YinniKun/led_flight_info/models/complete_enclosure_assembly_neg10deg.stl

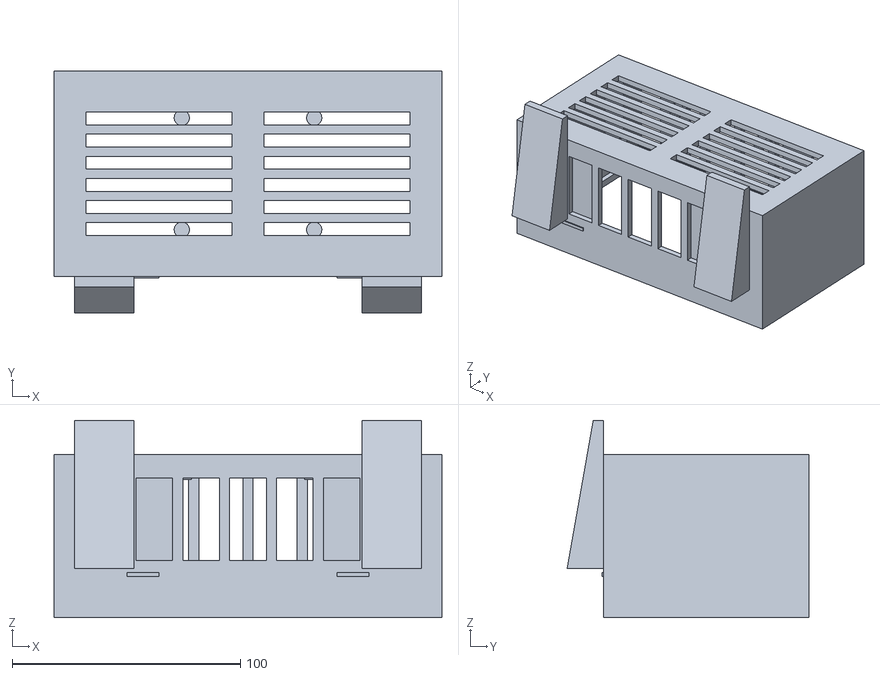
[picture p1: CAD file, 2026-11-08]
models/complete_enclosure_assembly_neg10deg.stl
170.0 x 106.0 x 86.5
