YinniKun/led_flight_info/models/rear_chassis_enclosure.stl

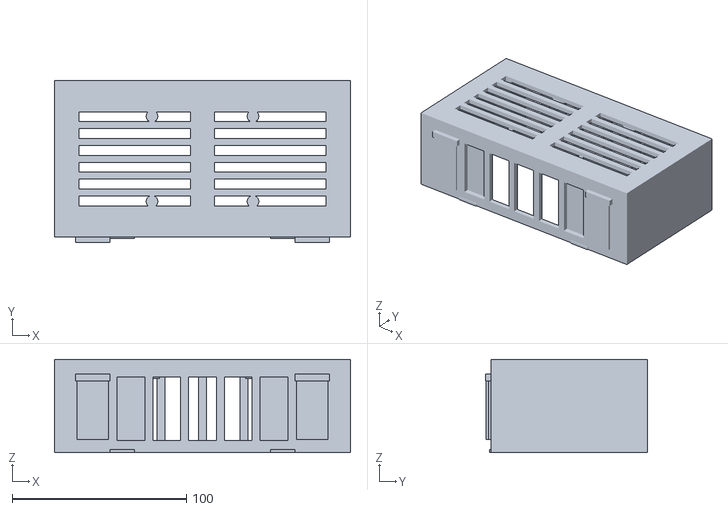
[picture p2: CAD file, 2026-11-08]
models/rear_chassis_enclosure.stl
170.0 x 93.0 x 53.5
