YinniKun/led_flight_info/models/display_front_bezel.stl

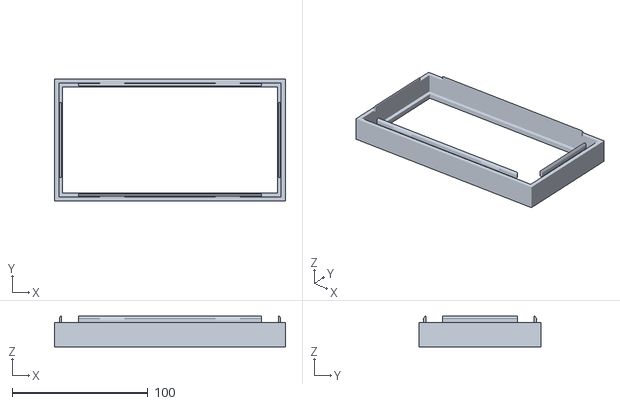
[picture p3: CAD file, 2026-11-08]
models/display_front_bezel.stl
170.0 x 90.0 x 22.5
