YinniKun/led_flight_info/models/modular_foot_-15deg.stl

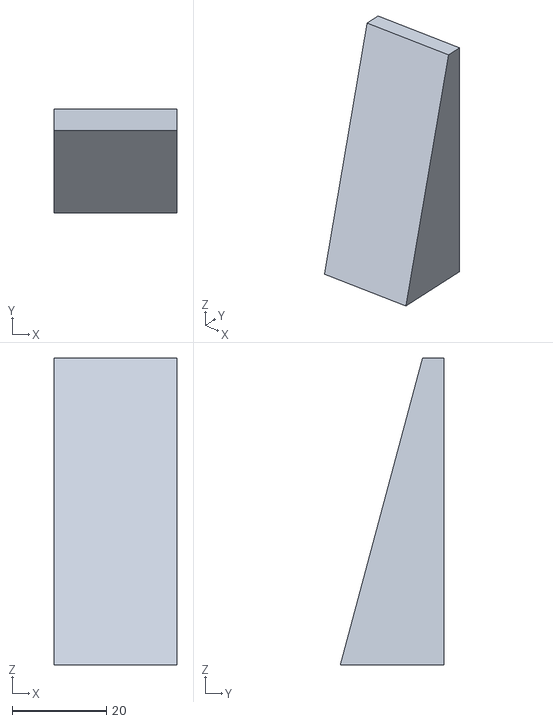
[picture p4: CAD file, 2026-11-08]
models/modular_foot_-15deg.stl
26.0 x 21.9 x 65.0
