YinniKun/led_flight_info/models/modular_foot_-10deg.stl

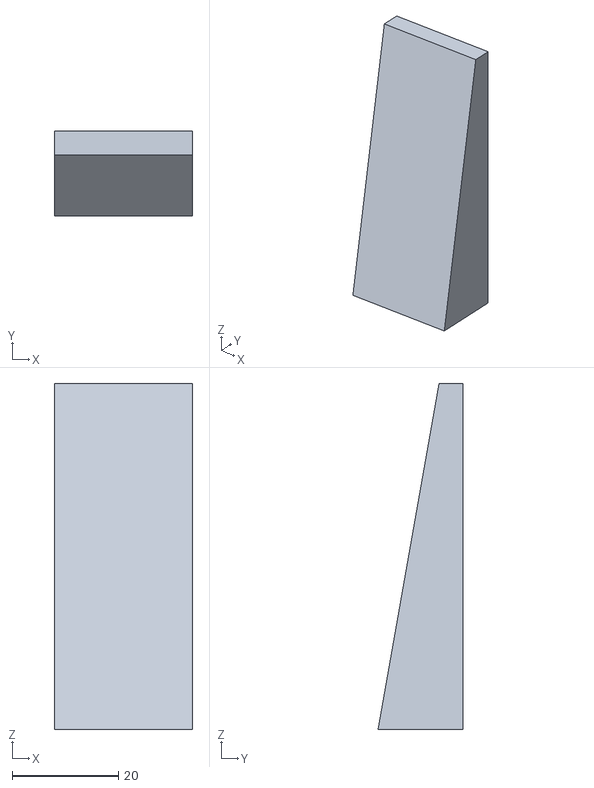
[picture p5: CAD file, 2026-11-08]
models/modular_foot_-10deg.stl
26.0 x 16.0 x 65.0
