YinniKun/led_flight_info/models/modular_foot_pos15deg.stl

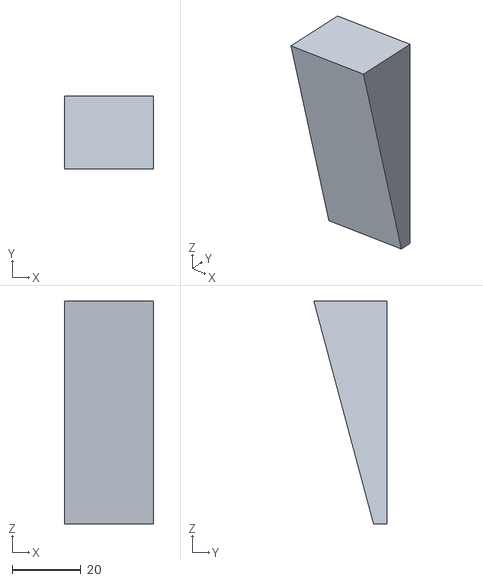
[picture p6: CAD file, 2026-11-08]
models/modular_foot_pos15deg.stl
26.0 x 21.4 x 65.0
