YinniKun/led_flight_info/models/modular_foot_pos10deg.stl

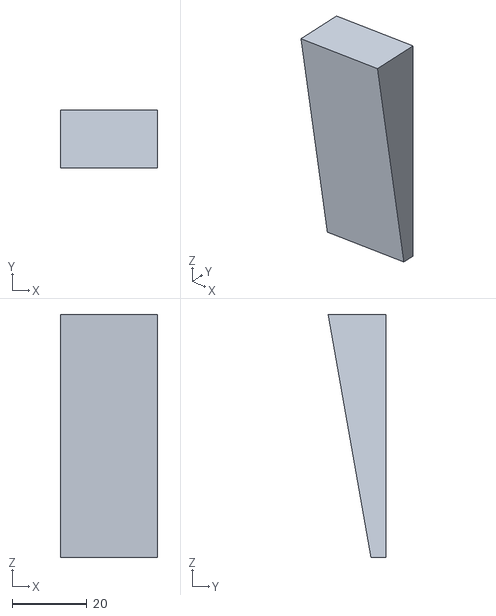
[picture p7: CAD file, 2026-11-08]
models/modular_foot_pos10deg.stl
26.0 x 15.5 x 65.0
