YinniKun/led_flight_info/models/modular_foot_0deg.stl

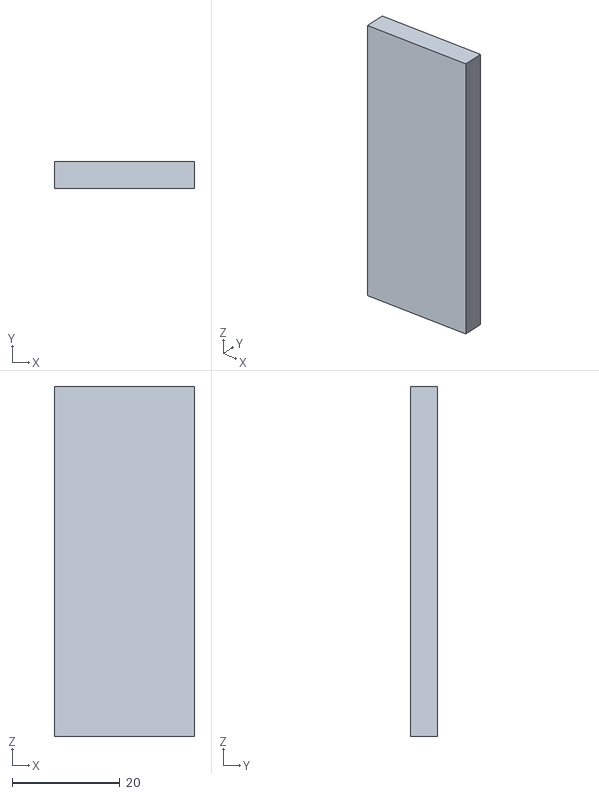
[picture p8: CAD file, 2026-11-08]
models/modular_foot_0deg.stl
26.0 x 5.00 x 65.0
