YinniKun/led_flight_info/models/modular_foot_neg5deg.stl

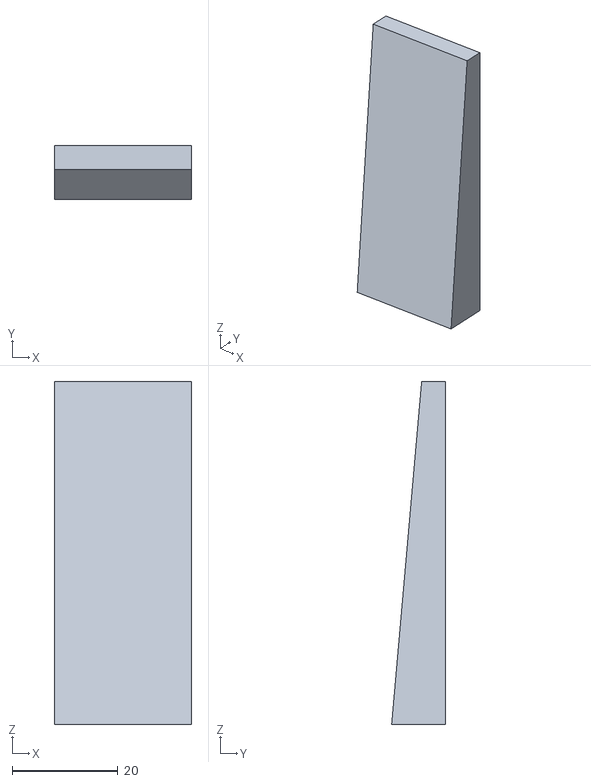
[picture p9: CAD file, 2026-11-08]
models/modular_foot_neg5deg.stl
26.0 x 10.2 x 65.0
