YinniKun/led_flight_info/(commit log)

2026-11-07 add 3d print models for hosting the pi and the display
    [complete_enclosure_assembly.stl, display_front_bezel.stl, modular_foot_0deg.stl, modular_foot_10deg.stl, modular_foot_15deg.stl, rear_chassis_enclosure.stl]
2026-11-07 add docs for printing and web portal explaination
2026-11-08 feat(3d): add negative angle modular feet (-5°, -10°, -15°) for backward desktop recline
    [complete_enclosure_assembly.stl, complete_enclosure_assembly_neg10deg.stl, display_front_bezel.stl, modular_foot_-10deg.stl, modular_foot_-15deg.stl, modular_foot_-5deg.stl, modular_foot_0deg.stl, modular_foot_10deg.stl]
2026-11-08 fix(weather): ensure weather ticker completes full scroll before switching screens
